loki42/PolyExpressive/app/kivy/assets/print_background.jpg

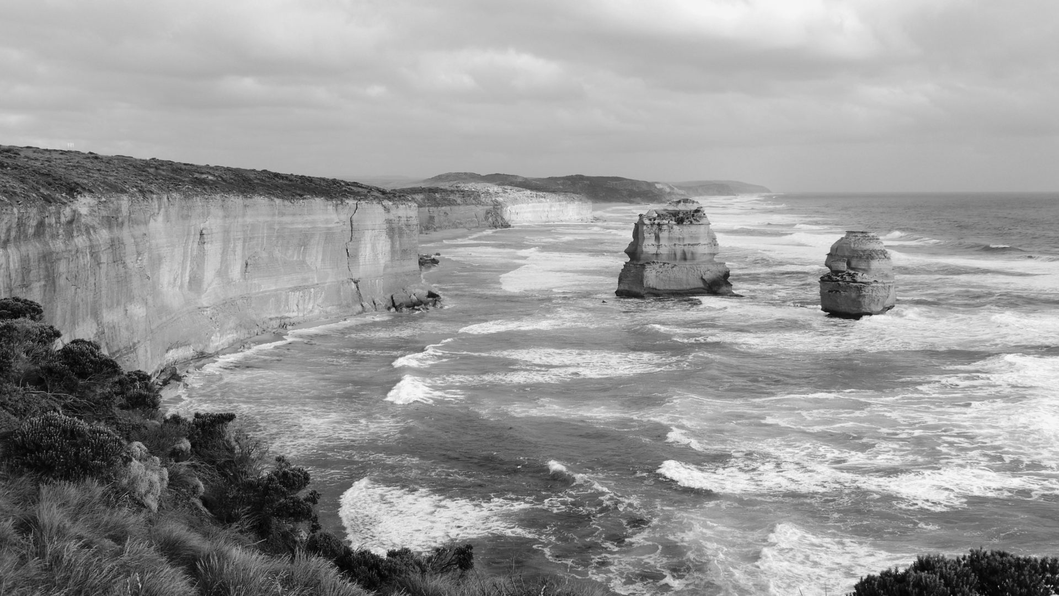
app/kivy/assets/print_background.jpg
