loki42/PolyExpressive/app/kivy/assets/layout4.png

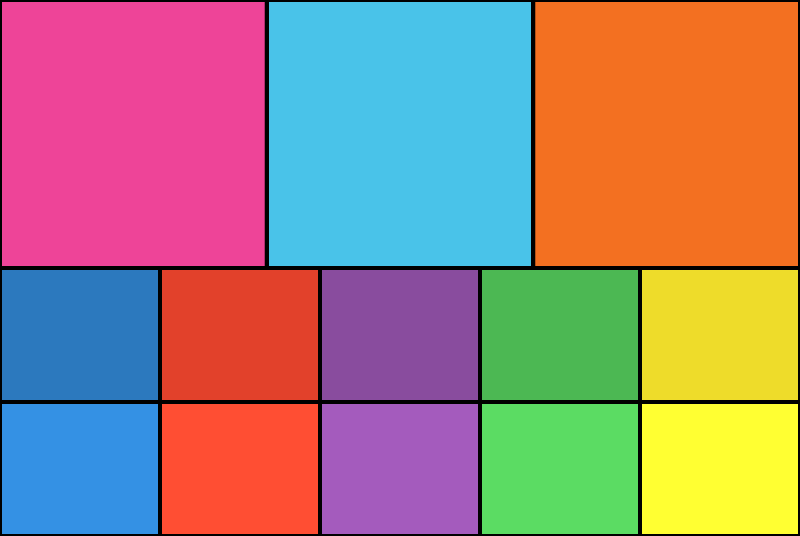
app/kivy/assets/layout4.png
