loki42/PolyExpressive/app/kivy/assets/layout1.png

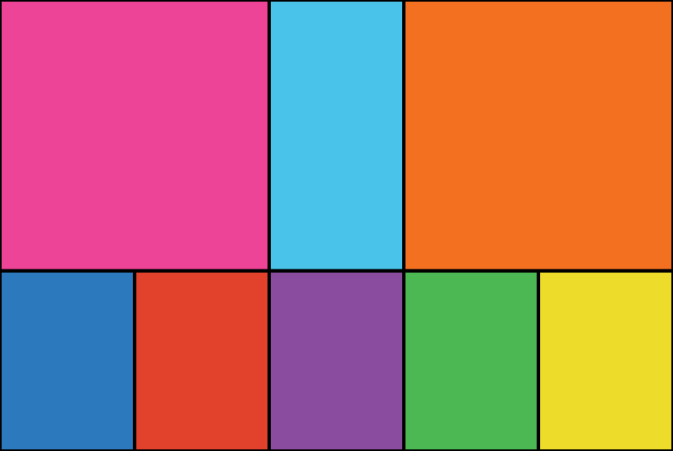
app/kivy/assets/layout1.png
