loki42/PolyExpressive/app/kivy/assets/layout2.png

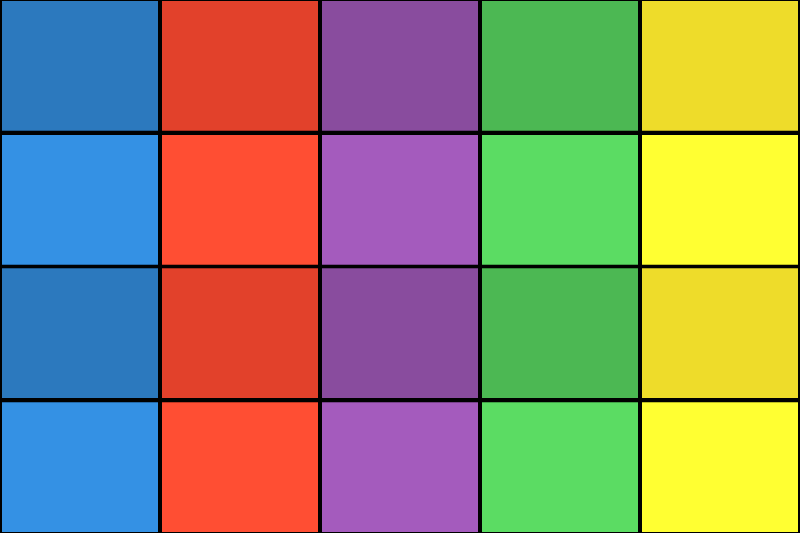
app/kivy/assets/layout2.png
