loki42/PolyExpressive/app/kivy/assets/layout3.png

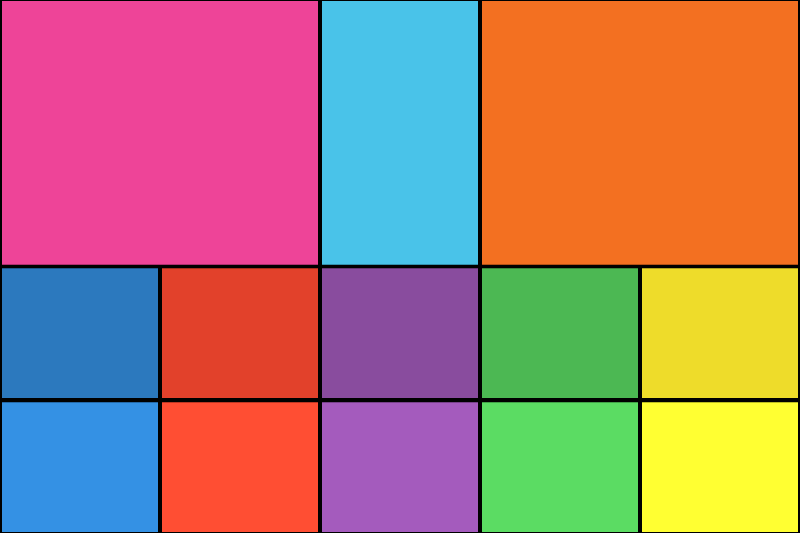
app/kivy/assets/layout3.png
