loki42/PolyExpressive/app/kivy/assets/layout5.png

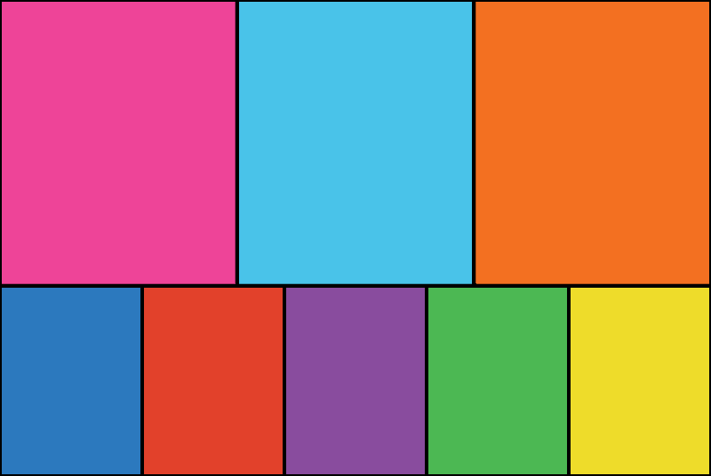
app/kivy/assets/layout5.png
