loki42/PolyExpressive/app/kivy/assets/layout6.png

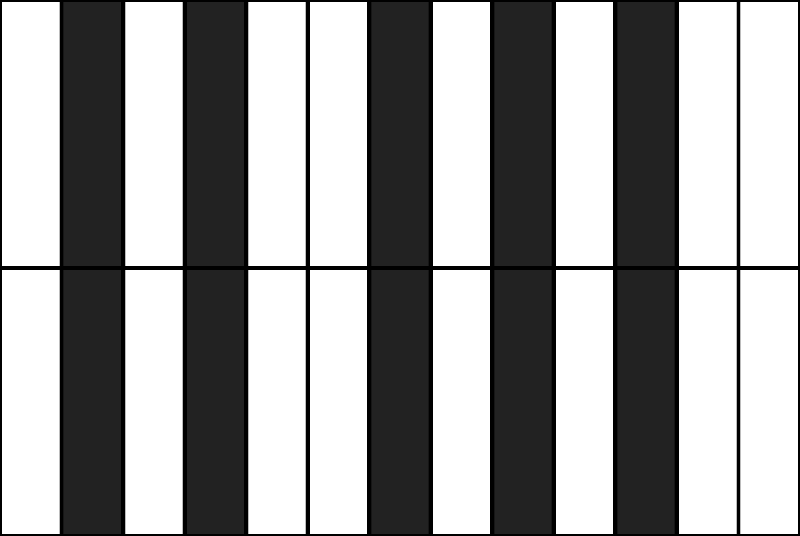
app/kivy/assets/layout6.png
