loki42/PolyExpressive/app/kivy/assets/layout7.png

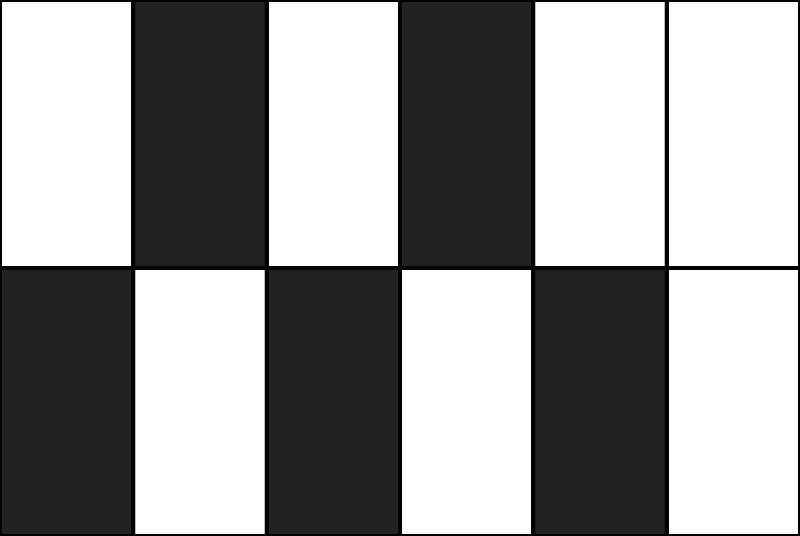
app/kivy/assets/layout7.png
