loki42/PolyExpressive/app/kivy/assets/layout8.png

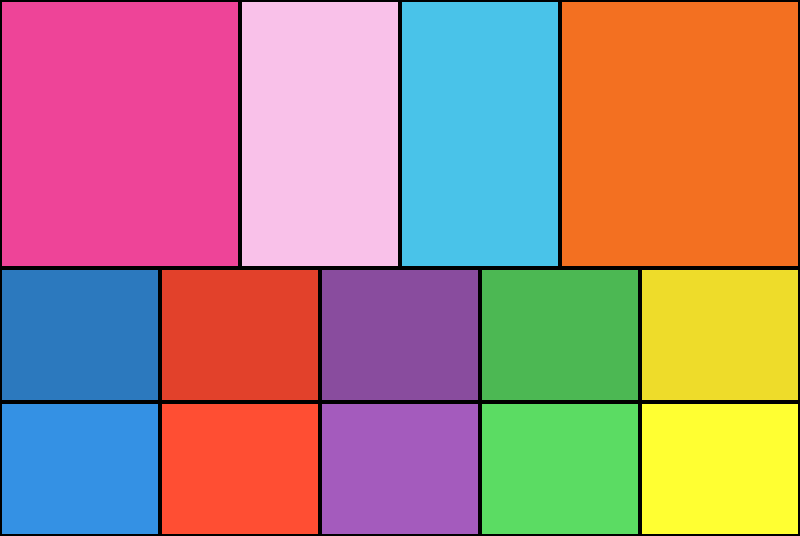
app/kivy/assets/layout8.png
