loki42/PolyExpressive/app/kivy/assets/layout9.png

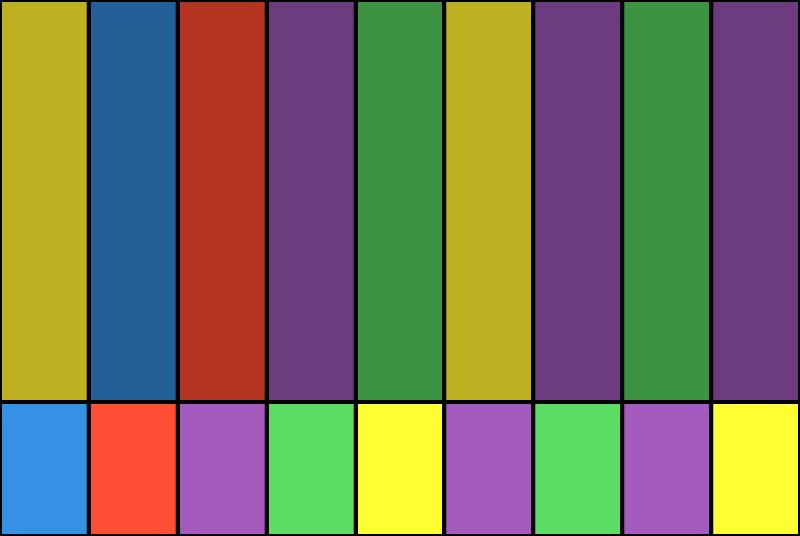
app/kivy/assets/layout9.png
