loki42/PolyExpressive/app/kivy/assets/layout10.png

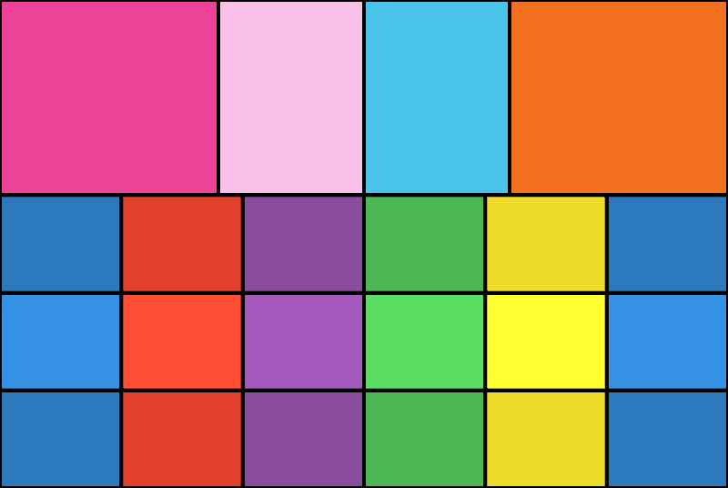
app/kivy/assets/layout10.png
