loki42/PolyExpressive/(commit log)

2017-08-09 added resistive touch code, not yet working
2017-08-23 basic working i2c version and start of action def
2017-08-30 aded kicad file
    [kicad.kicad_pcb, kicad.sch]
2017-08-30 labelled schematic
    [kicad.sch]
2017-08-31 added footprints
    [kicad.kicad_pcb, kicad.sch]
2017-09-02 start drawing traces
    [kicad.kicad_pcb, kicad.sch]
2017-09-02 pours done
    [kicad.kicad_pcb]
2017-09-02 2 pins to go
    [kicad.kicad_pcb]
2017-09-02 change board shape to have cutouts
    [kicad.kicad_pcb, kicad.sch]
2017-09-04 about to add dfx outline
    [kicad.kicad_pcb, kicad.sch]
2017-09-04 added outline and mounting screws
    [kicad.kicad_pcb]
2017-09-05 add fids
    [kicad.kicad_pcb]
2017-09-05 generated gerbers, but need to check gpio of wroom
    [kicad.kicad_pcb, kicad.sch]
2017-09-05 changed wroom pins to the io pins and added pull ups to the i2c bus
    [kicad.kicad_pcb, kicad.sch]
2017-09-05 submitted version
    [kicad.kicad_pcb]
2017-09-13 convert point to mm and step files to pcb
    [kicad.kicad_pcb]
2017-09-26 attempting ST i2c but does not work yet
    [I2CTouch.py]
2017-09-28 i2c works now on micrpython firmware
2017-10-03 fix for running on standard firmware, add status checking for touch
    [I2CTouch.py, PolyExpressive.py, boot.py]
2017-10-03 now send that finger is up after waiting for 20 calls to get_p that return empty buffer
2017-10-20 mat axis is not correct
    [main.py]
2017-10-24 fix issue with fireware only sending first CC, added PDF print output
    [PolyExpressive.py, main.py]
2017-10-25 was sending on the wrong midi channel and add initial M9 support
    [main.py]
2017-11-02 add initial echolution support and fix issue with new layouts missing final cell
    [main.py]
2017-11-16 fix typo in H&K
    [main.py]
2018-01-01 add some more presets, need to fix this to flexible system
    [main.py]
2018-02-16 set board size for printing
2018-04-05 fixed list size issue for enum select
    [main.py]
2018-04-06 fix layout issue in firmware with size, fixed issue with PDFs with multiple things on an axis
    [I2CTouch.py, PolyExpressive.py, main.py]
2018-04-13 fix to background image
    [main.py]
2018-04-19 fixed pdf output crash if file is open and reset mat on reload
    [main.py]
2018-05-11 change num empty trigger to much longer to filter out false end events. Improved custom pedal support in app
2018-05-17 fixed on_disabled bug in kivymd on mac, added firmware updating to app, added searching to datalists
    [PolyExpressive.py, main.py]
2018-05-30 added native file browsers and export and load of boards
2018-07-03 fix issue with foot up breaking sending to poly, added bim oto.
    [main.py]
2018-08-31 improve h9 support and update kicad lib
    [kicad.sch]
2018-09-03 changed codec to adc
2018-09-05 adding some stuff to kicad lib
2018-09-07 pcb library update
2018-09-24 added new adau footprint
2018-12-17 updated footprints
2019-03-15 added new footprints
2019-09-10 added pcb lib
